FatherNelson/ee2361/final_schematic.sch

## EAGLE design final_schematic.sch (2018-05-05)

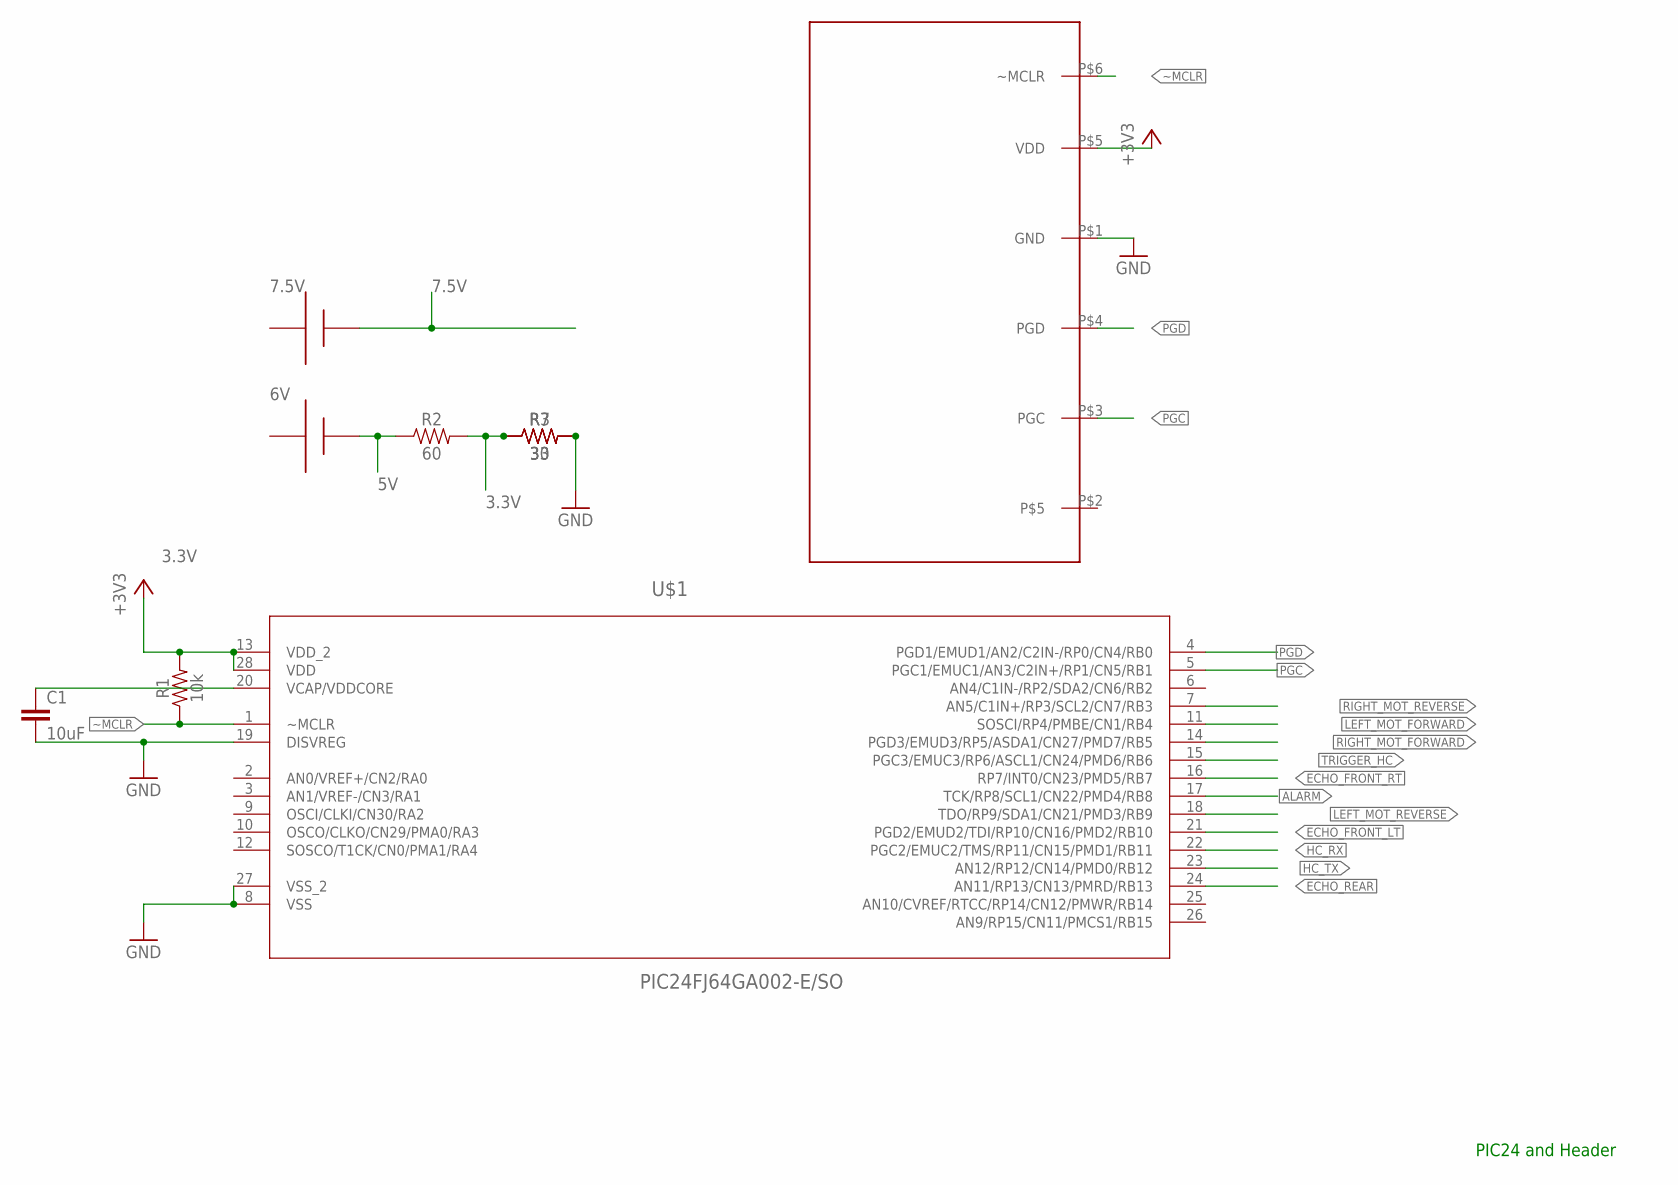
[picture p1: schematic final_schematic.sch, sheet 1]

Parts:
6V, 7.5V: AAA; 12BH412
C1: 10uF; 0603
R1: 10k; 0603
R2: 60; 0603
R3: 33; 0603
R7: 30; 0603
U$1: PIC24FJ64GA002-E/SO; SOIC127P1030X265-28N
U$2: CHIPKITHEADER; HEADER

Connections:
3.3V: R1.2, R2.2, R3.1, R7.1, U$1.13 (VDD_2), U$1.28 (VDD)
5V: 6V.+, R2.1
7.5V: 7.5V.+
+3V3: U$2.P$5 (VDD)
ALARM: U$1.17 (TCK/RP8/SCL1/CN22/PMD4/RB8)
ECHO_FRONT_LT: U$1.21 (PGD2/EMUD2/TDI/RP10/CN16/PMD2/RB10)
ECHO_FRONT_RT: U$1.16 (RP7/INT0/CN23/PMD5/RB7)
ECHO_REAR: U$1.24 (AN11/RP13/CN13/PMRD/RB13)
GND: C1.2, R3.2, R7.2, U$1.8 (VSS), U$1.19 (DISVREG), U$1.27 (VSS_2), U$2.P$1 (GND)
HC_RX: U$1.22 (PGC2/EMUC2/TMS/RP11/CN15/PMD1/RB11)
HC_TX: U$1.23 (AN12/RP12/CN14/PMD0/RB12)
LEFT_MOT_FORWARD: U$1.11 (SOSCI/RP4/PMBE/CN1/RB4)
LEFT_MOT_REVERSE: U$1.18 (TDO/RP9/SDA1/CN21/PMD3/RB9)
unnamed: C1.1, U$1.20 (VCAP/VDDCORE)
PGC: U$1.5 (PGC1/EMUC1/AN3/C2IN+/RP1/CN5/RB1), U$2.P$3 (PGC)
PGD: U$1.4 (PGD1/EMUD1/AN2/C2IN-/RP0/CN4/RB0), U$2.P$4 (PGD)
RIGHT_MOT_FORWARD: U$1.14 (PGD3/EMUD3/RP5/ASDA1/CN27/PMD7/RB5)
RIGHT_MOT_REVERSE: U$1.7 (AN5/C1IN+/RP3/SCL2/CN7/RB3)
TRIGGER_HC: U$1.15 (PGC3/EMUC3/RP6/ASCL1/CN24/PMD6/RB6)
~MCLR: R1.1, U$1.1 (~MCLR), U$2.P$6 (~MCLR)

Notes on the sheet:
PIC24 and Header

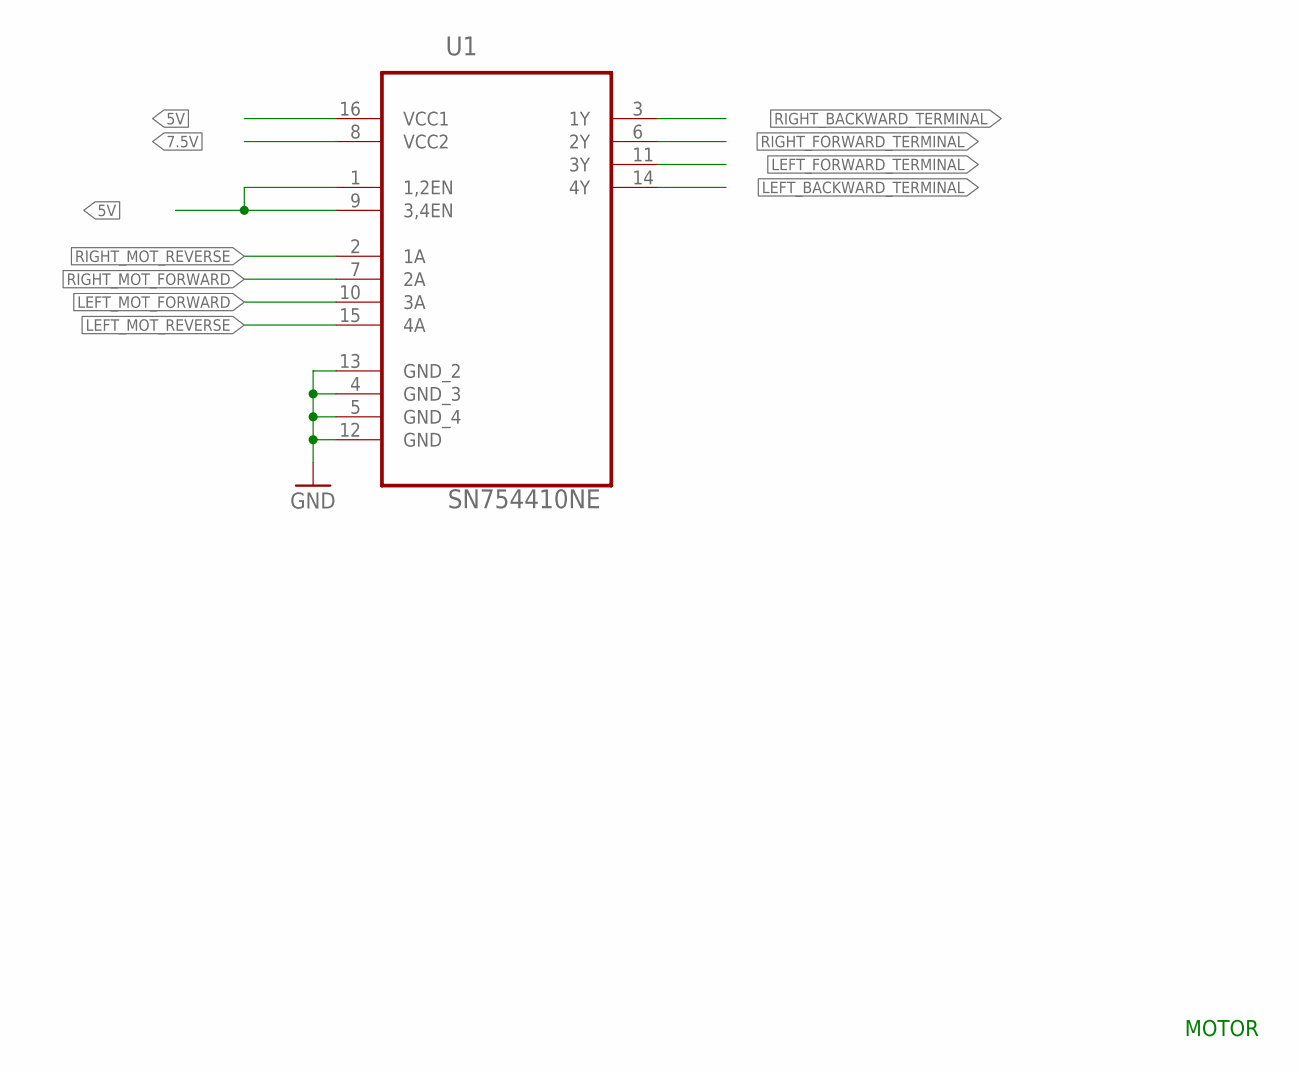
[picture p2: schematic final_schematic.sch, sheet 2]

Parts:
U1: SN754410NE; DIP254P762X508-16

Connections:
5V: U1.1 (1,2EN), U1.9 (3,4EN), U1.16 (VCC1)
7.5V: U1.8 (VCC2)
GND: U1.4 (GND_3), U1.5 (GND_4), U1.12 (GND), U1.13 (GND_2)
LEFT_BACKWARD_TERMINAL: U1.14 (4Y)
LEFT_FORWARD_TERMINAL: U1.11 (3Y)
LEFT_MOT_FORWARD: U1.10 (3A)
LEFT_MOT_REVERSE: U1.15 (4A)
RIGHT_BACKWARD_TERMINAL: U1.3 (1Y)
RIGHT_FORWARD_TERMINAL: U1.6 (2Y)
RIGHT_MOT_FORWARD: U1.7 (2A)
RIGHT_MOT_REVERSE: U1.2 (1A)

Notes on the sheet:
MOTOR

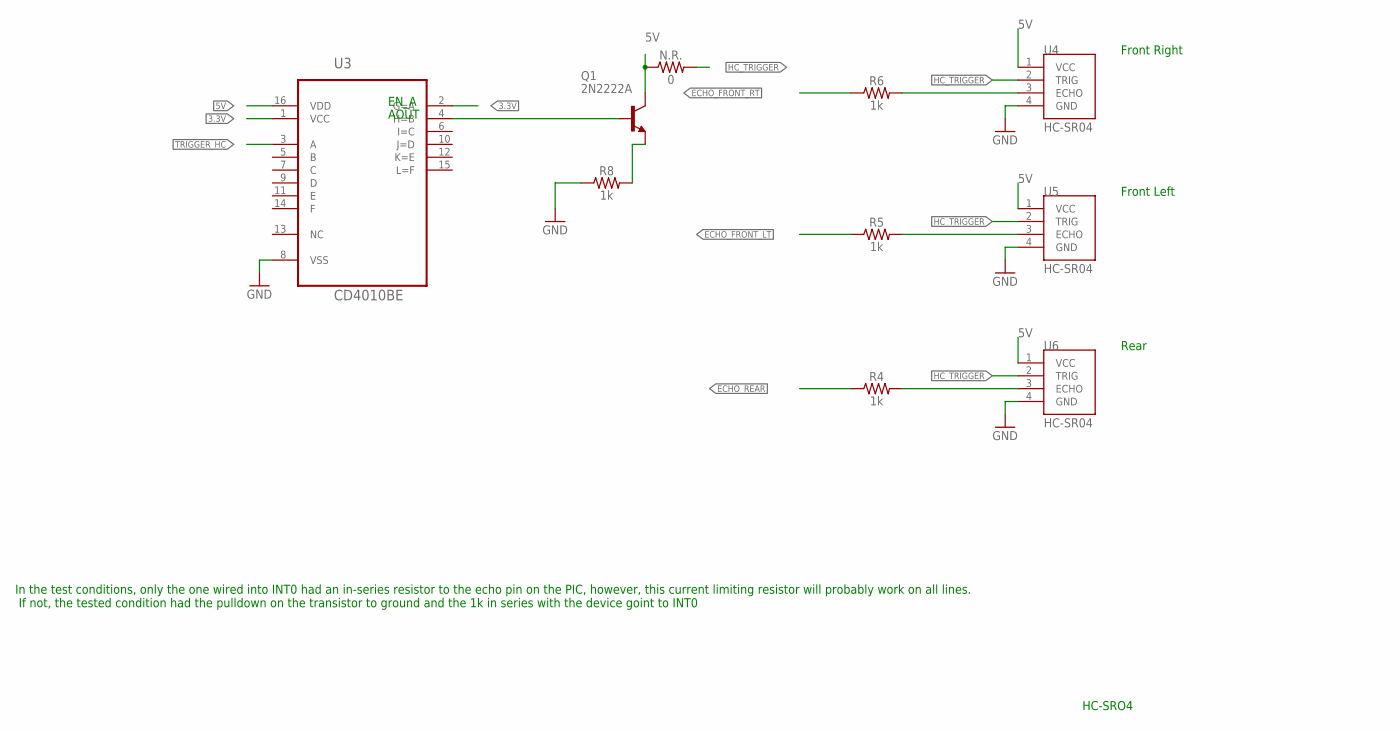
[picture p3: schematic final_schematic.sch, sheet 3]

Parts:
N.R.: 0; 1210
Q1: 2N2222A; TO18
R4, R5, R6, R8: 1k; 0603
U3: CD4010BE; DIP254P762X508-16
U4, U5, U6: HC-SR04; XCVR_HC-SR04

Connections:
3.3V: U3.1 (VCC), U3.2 (G=A)
5V: N.R..1, Q1.3 (C), U3.16 (VDD), U4.1 (VCC), U5.1 (VCC), U6.1 (VCC)
ECHO_FRONT_LT: R5.1
ECHO_FRONT_RT: R6.1
ECHO_REAR: R4.1
GND: R8.1, U3.8 (VSS), U4.4 (GND), U5.4 (GND), U6.4 (GND)
HC_TRIGGER: N.R..2, Q1.1 (E), Q1.2 (B), R8.2, U3.4 (H=B), U4.2 (TRIG), U5.2 (TRIG), U6.2 (TRIG)
unnamed: R4.2, U6.3 (ECHO)
unnamed: R6.2, U4.3 (ECHO)
unnamed: R5.2, U5.3 (ECHO)
TRIGGER_HC: U3.3 (A)

Notes on the sheet:
HC-SRO4
EN_A
AOUT
In the test conditions, only the one wired into INT0 had an in-series resistor to the echo pin on the PIC, however, this current limiting resistor will probably work on all lines. If not, the tested condition had the pulldown on the transistor to ground and the 1k in series with the device goint to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
Front Right
Front Left
Rear

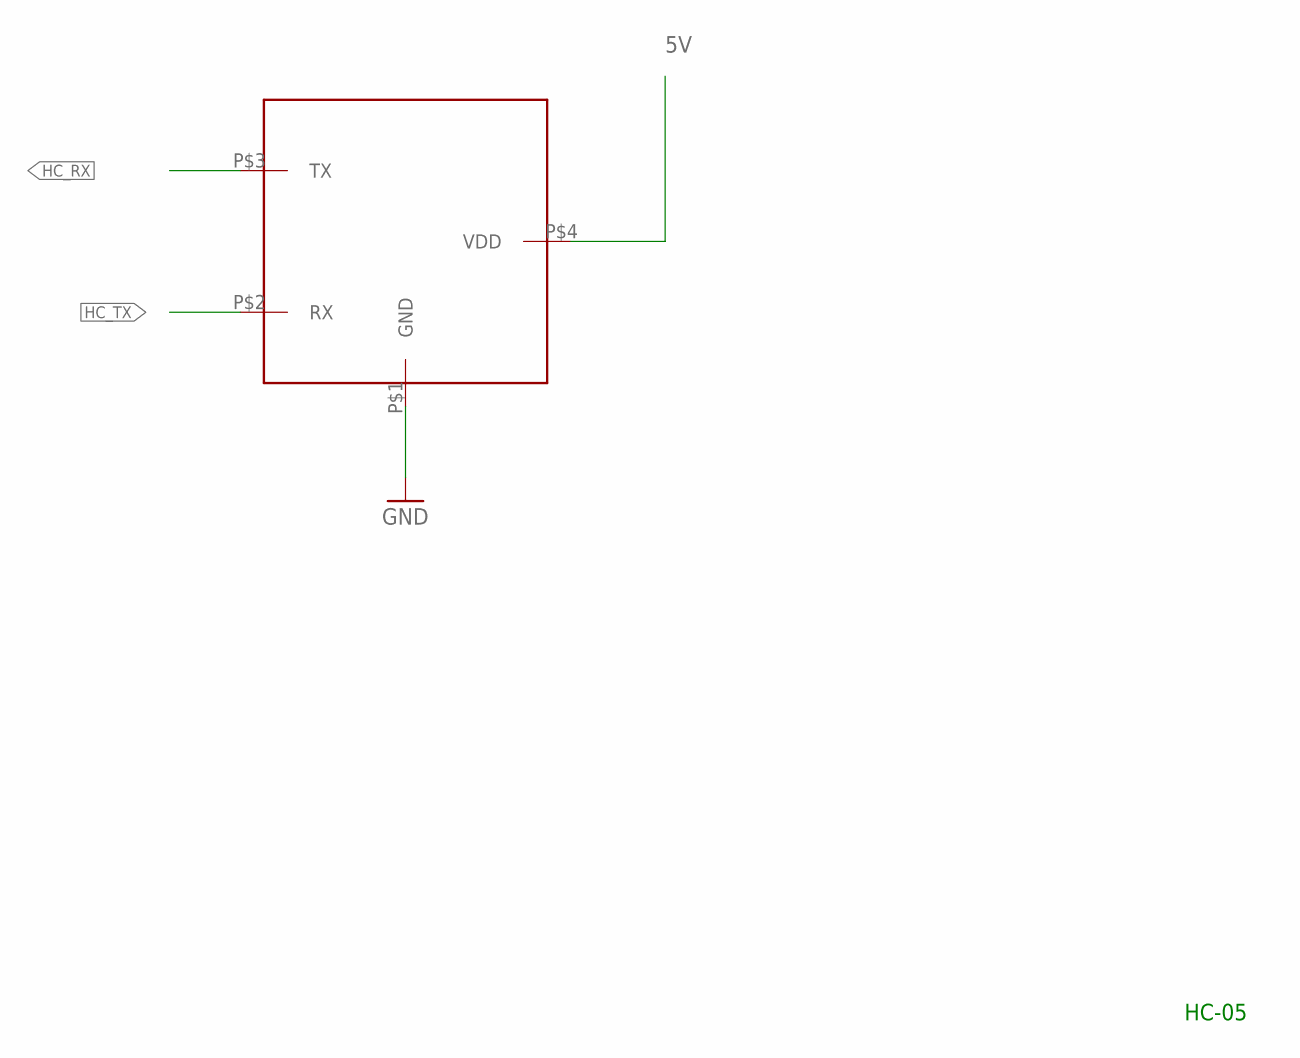
[picture p4: schematic final_schematic.sch, sheet 4]

Parts:
U$3: HC-05; HEADER

Connections:
5V: U$3.P$4 (VDD)
GND: U$3.P$1 (GND)
HC_RX: U$3.P$3 (TX)
HC_TX: U$3.P$2 (RX)

Notes on the sheet:
HC-05
