FatherNelson/ee2361/roborun.c

/*
 * File:   roborun.c
 * Author: Grant
 *
 * Created on April 12, 2018, 4:31 PM
 */


#include "xc.h"
#include "robot.h"

// PIC24FJ64GA002 Configuration Bit Settings
// CW1: FLASH CONFIGURATION WORD 1 (see PIC24 Family Reference Manual 24.1)
#pragma config ICS = PGx1          // Comm Channel Select (Emulator EMUC1/EMUD1 pins are shared with PGC1/PGD1)
#pragma config FWDTEN = OFF        // Watchdog Timer Enable (Watchdog Timer is disabled)
#pragma config GWRP = OFF          // General Code Segment Write Protect (Writes to program memory are allowed)
#pragma config GCP = OFF           // General Code Segment Code Protect (Code protection is disabled)
#pragma config JTAGEN = OFF        // JTAG Port Enable (JTAG port is disabled)


// CW2: FLASH CONFIGURATION WORD 2 (see PIC24 Family Reference Manual 24.1)
#pragma config POSCMOD = NONE           // Primary Oscillator Select (Primary oscillator disabled. 
					// Primary Oscillator refers to an external osc connected to the OSC1 and OSC2 pins)
#pragma config I2C1SEL = PRI       // I2C1 Pin Location Select (Use default SCL1/SDA1 pins)
#pragma config IOL1WAY = OFF       // IOLOCK Protection (IOLOCK may be changed via unlocking seq)
#pragma config OSCIOFNC = ON       // OSC2/CLKO/RC15 functions as port I/O (RC15)
#pragma config FCKSM = CSECME      // Clock Switching and Monitor (Clock switching is enabled, 
                                       // Fail-Safe Clock Monitor is enabled)
#pragma config FNOSC = FRCPLL      // Oscillator Select (Fast RC Oscillator with PLL module (FRCPLL))

//This is the file which sets up the operation of the droid that is driven by ISR's. Must be called, and contains the main function
int main(void) {
    setup_scan(); //perform setup for all three sensors and define their connections
    setup_motors(); //define the connections of the h-bridge and instantiate crucial motor modules (OC's and timers)
    setup_uart(); //Start uart interpretation by the PIC, allows commands to be processed
    while(1){
        //Terminate indefinitely, all processing is ISR driven.
    }
    return 0;
}
