FatherNelson/ee2361/(commit log)

2018-04-21 Add files via upload
    Integrated a front and rear sensor with same trigger line
2018-04-21 Add files via upload
    Schematic
    [final_schematic.sch]
2018-04-25 added third sensor
2018-04-25 Add files via upload
    finalized sensor power circuitry and added HC-05. First functional robot
    [final_schematic.sch]
2018-04-28 Add files via upload
    added servo functions with calibration
2018-05-01 final schematic
    Final sc
    [final_schematic.sch]
2018-05-04 timer 3 fix
2018-05-04 fixed TRISBbits
    These were done in setup and are also the wrong ports
    [motiondetect_defs.c]
2018-05-05 finish version one schematic
    [final_schematic.sch]
2018-05-05 final schematic
    [final_schematic.sch]
